Hermann-SW/Raspberry_v1_camera_global_external_shutter/FCameraWebServer/res/ov2640.pins.10.jpg

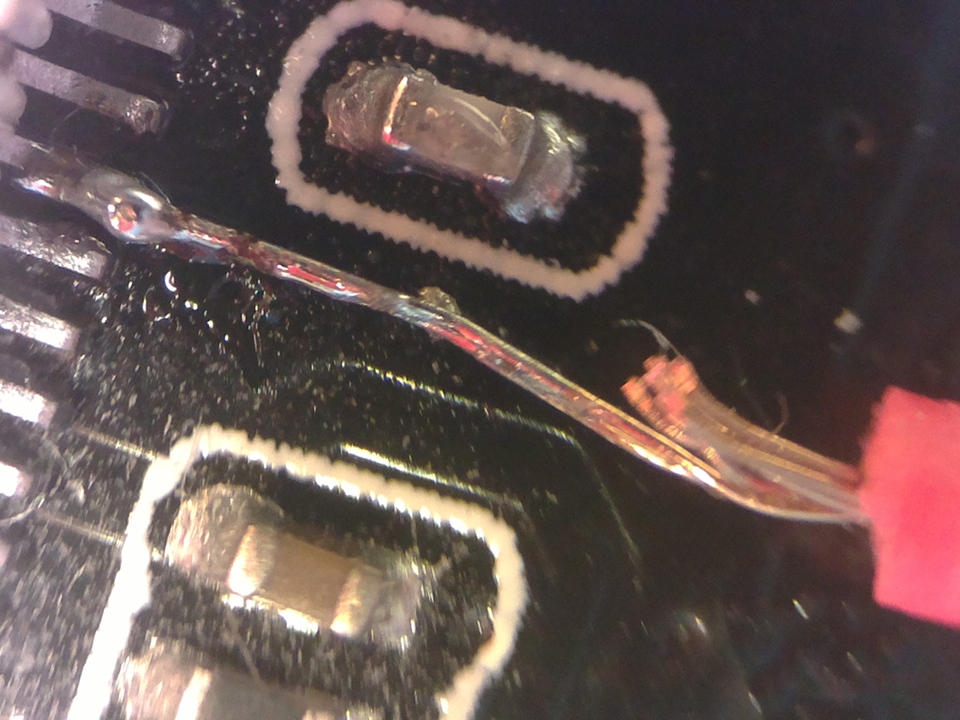
FCameraWebServer/res/ov2640.pins.10.jpg
