Hermann-SW/Raspberry_v1_camera_global_external_shutter/res/6mm.frame2915.jpg

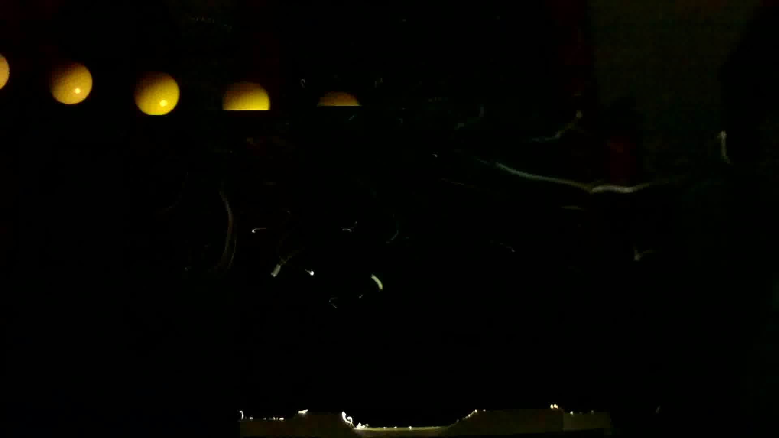
res/6mm.frame2915.jpg
