Hermann-SW/Raspberry_v1_camera_global_external_shutter/res/airgun.1b.jpg

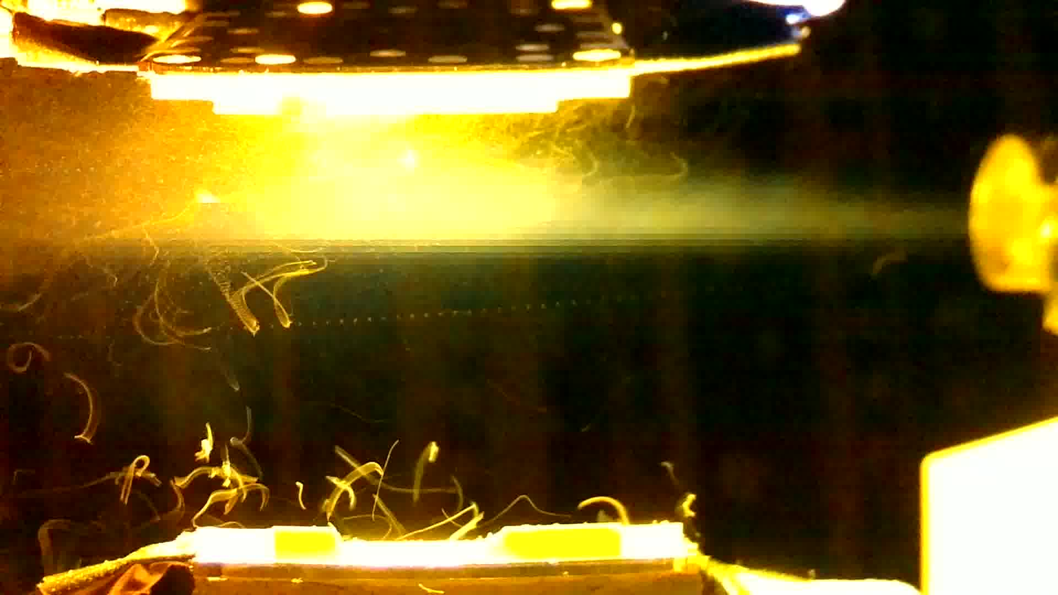
res/airgun.1b.jpg
