Hermann-SW/Raspberry_v1_camera_global_external_shutter/res/ges_requirements.jpg

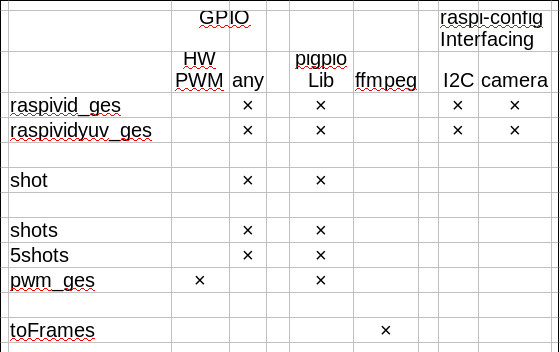
res/ges_requirements.jpg
