Hermann-SW/Raspberry_v1_camera_global_external_shutter/res/multiple-exposure.D.jpg

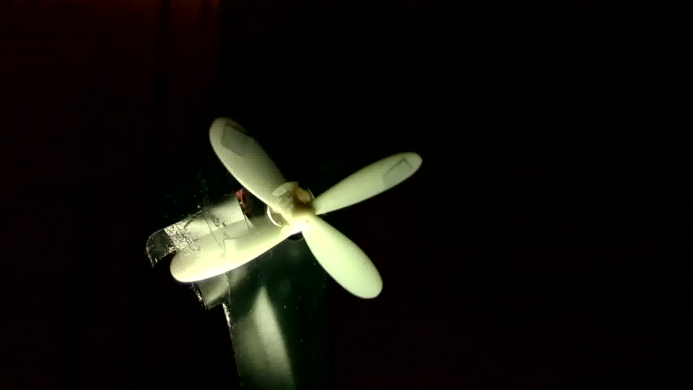
res/multiple-exposure.D.jpg
