Hermann-SW/Raspberry_v1_camera_global_external_shutter/res/multiple-exposure.F.jpg

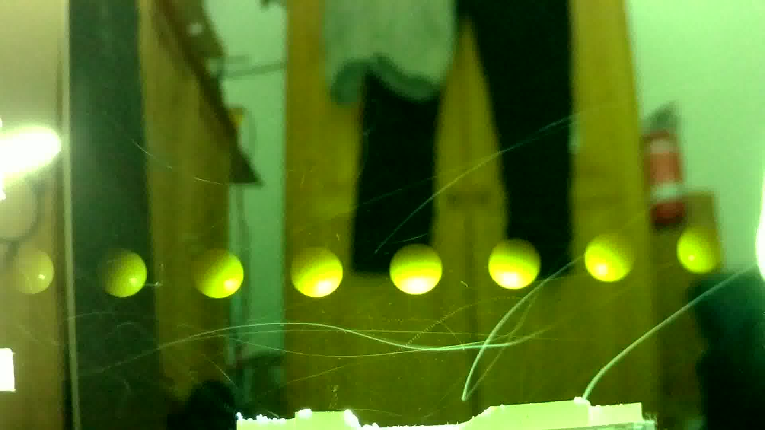
res/multiple-exposure.F.jpg
