Hermann-SW/Raspberry_v1_camera_global_external_shutter/res/two.HWsync.0a.jpg

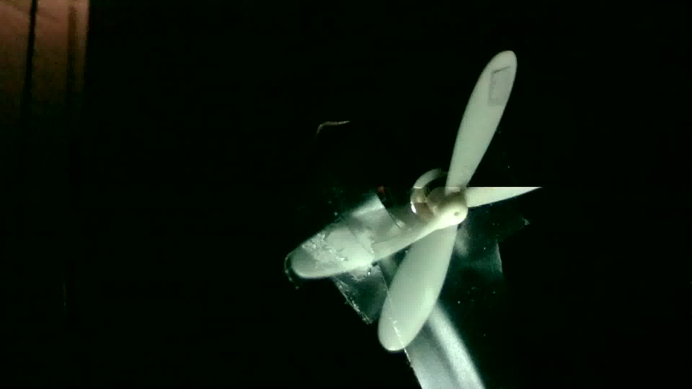
res/two.HWsync.0a.jpg
