Hermann-SW/Raspberry_v1_camera_global_external_shutter/res/two.HWsync.0b.jpg

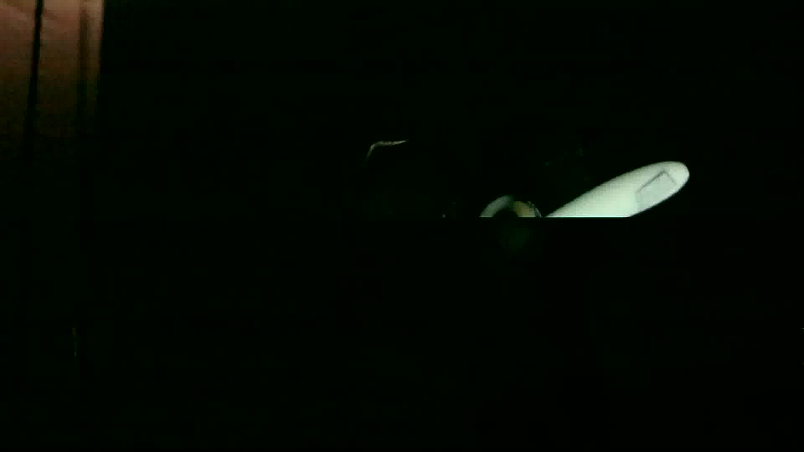
res/two.HWsync.0b.jpg
