Hermann-SW/Raspberry_v1_camera_global_external_shutter/res/two.HWsync.2.jpg

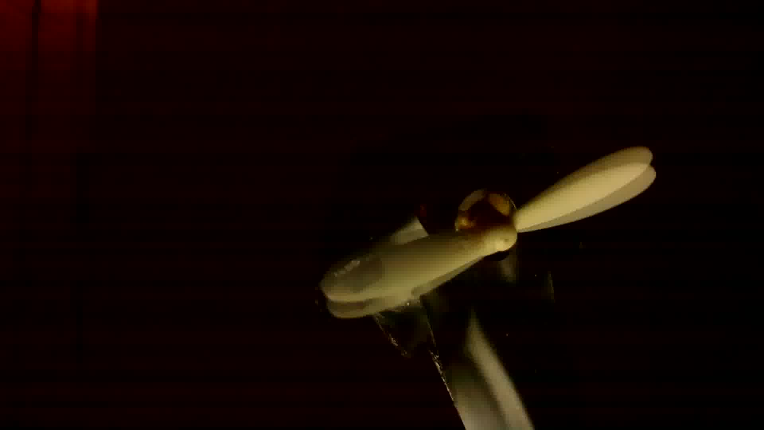
res/two.HWsync.2.jpg
