Hermann-SW/Raspberry_v1_camera_global_external_shutter/(threads)

Thread 1 (2019-12-10):

dl_lib.h is missing

consolacion, 2019-12-10:
dl_lib.h  seems missing, or is not included with the latest core.
comment out the #include line and still compiles fine

Hermann-SW, 2019-12-11:
Thanks, commited and pushed:
https://github.com/Hermann-SW/Raspberry_v1_camera_global_external_shutter/commit/79e2ede15fc0859b573597e40130928775e68c9

Closed 2019-12-26.

Thread 2 (2022-06-23):

Mult-camera sync possible?

ibprojects, 2022-06-23:
Hi Hermann,

Is it possible to sync multiple cameras using FREX?

I'm trying to use inexpensive cameras to create this:

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

If you know a good path for this with ESP32s or RPis I would really enjoy speaking with you. Happy to pay for your time.

Thank you!
Ian ianbroyles at gmail

(Please delete this if this is not the right place for this)

ibprojects, 2022-07-01:
That's a great project!

The setup is similar to what I had in mind with ESP32s with cameras:

4 ESP32-camera-units mounted behind a physical shutter in darkness.

1) Open shutters on cameras via long exposure or FREX mode
2) Open and close the physical shutter (and pop a flash if needed)
3) Write out image to SD card and send to host computer / phone (via Wifi)
4) Use host computer / phone (I am an iOS developer so I can make an app) to sew images together in GIF or movie.

My other approach was to use FPGAs and get the cameras all in sync similar to this:
(I need to gain more experience in this area)

https://www.xilinx.com/video/corporate/real-time-collaboration-panoramic-video-conferencing.html

Thank you for your reply, it is very helpful. I wish there was an easier way to get 4 inexpensive cameras completely in sync :)

Closed 2022-07-01.

Thread 3 (2022-07-02):

Raspiraw

AlzuhiriMohand, 2022-07-02:
Is it possible to acquire raw data with global shutter? I noticed that you mentioned raspiraw_ges but I cannot find in the tools.

Hermann-SW, 2022-07-02:
You can find all tools in "tools" directory, raspivid_ges did use raspividyuv, but capturing raw is possible eg. with using "raspivid" with "--raw" option

AlzuhiriMohand, 2022-07-05:
Thank you for the quick reply, I need raspiraw because I need 10-bit Bayer data, at 1664*1232 at 15 fps, and a preview window (to my knowledge, only raspiraw can provide that). The only problem here is that I am losing the hardware camera synch pulses (https://forums.raspberrypi.com/viewtopic.php?t=190314). Is losing the pulses normal or I am doing something wrong? Any idea about a workaround?

Hermann-SW, 2022-07-06:
Hardware sync pulses are generated by raspivid, and are missing in raspiraw.

But you can add them in this line:
https://github.com/raspberrypi/raspiraw/blob/master/raspiraw.c#L700

Closed 2022-07-07.

Thread 4 (2023-03-29):

Trouble consistently timing flash with fully exposed frame.

hendrikvg, 2023-03-29:
First off, cool project you've worked on!

I've been trying to recreate your results on an ESP32-CAM (also the AI Thinker model), but using the ESP-IDF framework instead of Arduino. I also use the RMT peripheral, with a 20 ms delay and a 0,1 ms flash. I learnt that the exposure setting dictates the maximum number of rows that are exposed simultaneously, as my vertical resolution consists of 600 rows (cropped) I set the exposure >600.
A major difference is that I'm not using the web interface, and I would like it to synchronize the flash with a fully exposed frame at ~10 fps. At the moment 1/5 of my pictures are completely exposed while using the flash.

There seems to be some oddities:
- The only real way to know when it is capturing a frame is by emptying the frame buffer with .fb_count = 1, it will take a single picture after this.
- Capturing a frame may take anywhere between 20 to 90 ms.

Especially the last item makes it difficult to consistently time the flash with a fully exposed frame.

Did I miss something about your approach? Would you happen to know any workaround?
