Hermann-SW/Raspberry_v1_camera_global_external_shutter/FCameraWebServer/camera_index.h

//File: index_ov2640.html.gz, Size: 4941
#define index_ov2640_html_gz_len 4941
const uint8_t index_ov2640_html_gz[] = {
 0x1F, 0x8B, 0x08, 0x08, 0x19, 0xD4, 0x1B, 0x5D, 0x00, 0x03, 0x69, 0x6E, 0x64, 0x65, 0x78, 0x2E,
 0x68, 0x74, 0x6D, 0x6C, 0x00, 0xE5, 0x3D, 0xEB, 0x72, 0xDA, 0x48, 0xBA, 0xFF, 0xFD, 0x14, 0x8A,
 0x66, 0x36, 0x86, 0x5A, 0x83, 0x01, 0x3B, 0x8E, 0xC7, 0x63, 0x34, 0x9B, 0x38, 0x4E, 0x32, 0x55,
 0xB9, 0x6D, 0x3C, 0x9B, 0xEC, 0xA9, 0xA9, 0x29, 0xA7, 0x91, 0x5A, 0xA0, 0x8D, 0x90, 0x58, 0x5D,
 0xC0, 0xDE, 0x94, 0x9F, 0xE3, 0x3C, 0xC9, 0x79, 0x81, 0xDD, 0x17, 0x3B, 0x5F, 0x5F, 0xD4, 0x6A,
 0x49, 0xAD, 0x1B, 0xC4, 0x90, 0x93, 0x43, 0xAA, 0x82, 0x90, 0xFA, 0xFB, 0xFA, 0xBB, 0x5F, 0x9A,
 0xA6, 0x7D, 0xFE, 0xC0, 0xF2, 0xCD, 0xE8, 0x76, 0x81, 0xB5, 0x59, 0x34, 0x77, 0x8D, 0xBD, 0x73,
 0xF6, 0xA6, 0xC1, 0xEB, 0x7C, 0x86, 0x91, 0xC5, 0x2E, 0xE9, 0xC7, 0x39, 0x8E, 0x90, 0x66, 0xCE,
 0x50, 0x10, 0xE2, 0x68, 0xAC, 0xC7, 0x91, 0xDD, 0x3B, 0xD5, 0xF3, 0x8F, 0x3D, 0x34, 0xC7, 0x63,
 0x7D, 0xE9, 0xE0, 0xD5, 0xC2, 0x0F, 0x22, 0x5D, 0x33, 0x7D, 0x2F, 0xC2, 0x1E, 0x0C, 0x5F, 0x39,
 0x56, 0x34, 0x1B, 0x5B, 0x78, 0xE9, 0x98, 0xB8, 0x47, 0x3F, 0x1C, 0x38, 0x9E, 0x13, 0x39, 0xC8,
 0xED, 0x85, 0x26, 0x72, 0xF1, 0x78, 0x28, 0xE3, 0x8A, 0x9C, 0xC8, 0xC5, 0xC6, 0xE5, 0xD5, 0xBB,
 0xA3, 0x91, 0xF6, 0xF6, 0xC3, 0xE8, 0xF8, 0x64, 0x70, 0x7E, 0xC8, 0xEE, 0xA5, 0x63, 0xC2, 0xE8,
 0x56, 0xFE, 0x4C, 0x5E, 0x13, 0xDF, 0xBA, 0xD5, 0xBE, 0x64, 0x6E, 0x91, 0x97, 0x0D, 0x44, 0xF4,
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
 0xC0, 0xC7, 0x1A, 0x95, 0x0B, 0x62, 0x46, 0xB5, 0x88, 0x3E, 0x6C, 0xD8, 0xA7, 0x42, 0xCA, 0x61,
 0x9F, 0xD2, 0x00, 0xD2, 0xE8, 0xC8, 0xD9, 0x17, 0xE1, 0xA5, 0x4A, 0x98, 0x87, 0x19, 0xFB, 0xCC,
 0xD1, 0x55, 0xBD, 0x10, 0xBB, 0x68, 0x50, 0x84, 0x21, 0x94, 0x59, 0xAB, 0x06, 0x43, 0x97, 0x33,
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
};
