Hermann-SW/Raspberry_v1_camera_global_external_shutter/(commit log)

2019-05-30 link back to associated Raspberry forum thread
2019-05-31 move PWM to multiple sublist
2019-06-01 Add airsoft pistol image as well as vertical down led setup
2019-06-01 Add heatsink
2019-06-01 passive cooler -> aluminum heatsink
2019-06-02 + pwm_ges tool
2019-06-02 Add eps definition and sample calculations.
2019-06-03 add two.HWsync.*.jpg frames
2019-06-03 add section of hardware camera sync pulses and new tool
2019-06-03 fix direct gpio number
    [gpio_alert.c]
2019-06-03 Enable gpio_alert.c to output N camera synched double exposure frames
2019-06-03 fix gpio_alert.c initial comment
    [gpio_alert.c]
2019-06-03 fix strange frame links
2019-06-04 photo+frame for setup w/o reflector
2019-06-04 + two new airsoft pistol bullet inflight frames
2019-06-05 + 7 frames from 3 airsoft pistol shots with dark background
2019-06-05 add led at bottom
2019-06-06 add xref to PWM
2019-06-08 + frame and animated .gif for 1st airgun shot
2019-06-08 Add 2-led setup information
2019-06-17 Add 90fps 640x480 captured frame and associated airgun shoot convenience script
2019-06-18 Add airgun clamped to desk setup. Improve setup crossref links to PWM exposure section captures.
2019-06-20 Add hardware camera sync pulses link
2019-06-21 Add undistorted 9000eps frame
2019-06-28 Initial commit of arduino-esp32 CameraWebServer example as FCameraWebServer. The 4 files are from this commit: https://github.com/espressif/arduino-esp32/commit/7b5cd47d07353747aa4b92bb9ac212d18371da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
2019-06-28 Add new "Flash" toggle to FCameraWebServer app. Add new tools allowing to easily extract index.html for modifying, and later compressing modified index.html into camera_index.h. Add README.md for thi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
2019-06-29 update redundant index/index.html to latest camera_index.h version. update tools to keep index/index.html
2019-07-01 Wire in doit button for "shot" mode. Use offset input (now ms instead of µs) for asynchronous wait in browser JS. Use feature that "window.stop" stops MJPEG streaming while leaving last frame nicely 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
2019-07-02 Add new "Wait for VSYNC" toggle and wire in.
2019-07-06 Expose VSYNC pin in global FCameraWebServer.ino variable. Use pin_vsync in app_httpd.cpp Make sure that more than a frame gets skipped for waiting for VSYNC.
    [FCameraWebServer.ino, app_httpd.cpp]
2019-07-15 Add successful global exyternal shutter captures. Add new section on differences to Raspberry v1 camera wrt global shutter. Remove soldering cable requirement.
2019-07-17 Add full mixed global+rlling shutter frame with possible explanation
2019-07-17 Add full global+rolling shutter effect frame with possible explanation
2019-08-03 Add anchor for setup with 2 leds
2019-08-11 Add "kFPS videos from kEPS multiple exposure frames" section with example 3000fps and 9000fps animations.
2019-08-16 Add photo from 8mm pointed pellet used and 1:1 from captured frame.
2019-09-02 Initial version of tool that allows to trigger a fixed amount of flashes with duration[us] at frequency[Hz] after offset[us] by microphone sensor.
    [audio_shots.c]
2019-09-05 Fix for: gpioWaveTxSend() inside alert function might freeze the Pi completely.
    [audio_shots.c]
2019-09-06 Add 5000fps animation of flying pellet, created by new technique from two frames, one with multiple exposure capturing of pellets, the other with multiple exposure but without pellets captured.
2019-09-07 Add wiring for sound trigger
2019-09-07 Mention vertical 5000lm led in setup
2019-09-07 Add tool's input frame sizes
2019-09-07 Add very fast camera panning 6000fps animation and generating tool
2019-09-07 Switch two frames in image in order to match textual description
2019-09-10 Add setup and description for 20000eps frame
2019-09-16 Add that daylight global shutter is possible for v1 camera as well
2019-09-16 Answer open question on v1 camera
2019-09-23 Really delete file in wrong location after move
    [shts.c]
2019-09-23 Change "shots" tool pigpiod sample size to 1us
2019-09-23 Change pigpiod sample size to 1us for some tools
2019-10-06 Add #3pellets experiment an results to PWM exposure section.
2021-02-02 Add "Update wrt. rolling shutter camera capturing airgun bullet inflight" section.
